nicholas12136/Senior-Design-Vivisense/mechanical/TowerConnector_to_tower.step

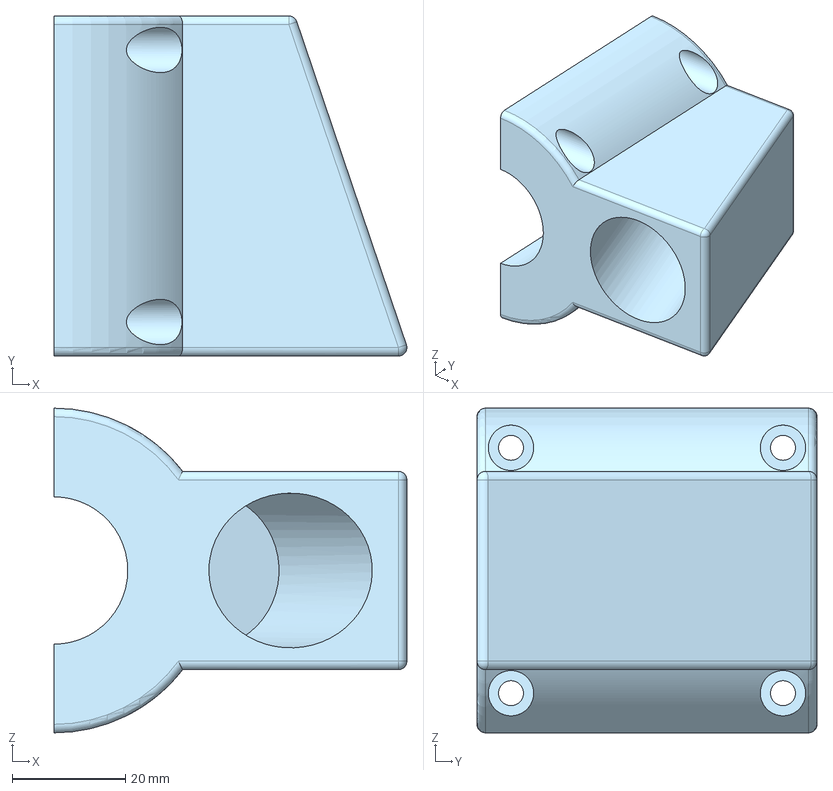
[picture p17: CAD file, 2026-05-02]
mechanical/TowerConnector_to_tower.step
62.3 x 60.0 x 57.3 mm
