nicholas12136/Senior-Design-Vivisense/mechanical/TowerLconnector_mirrored.stl

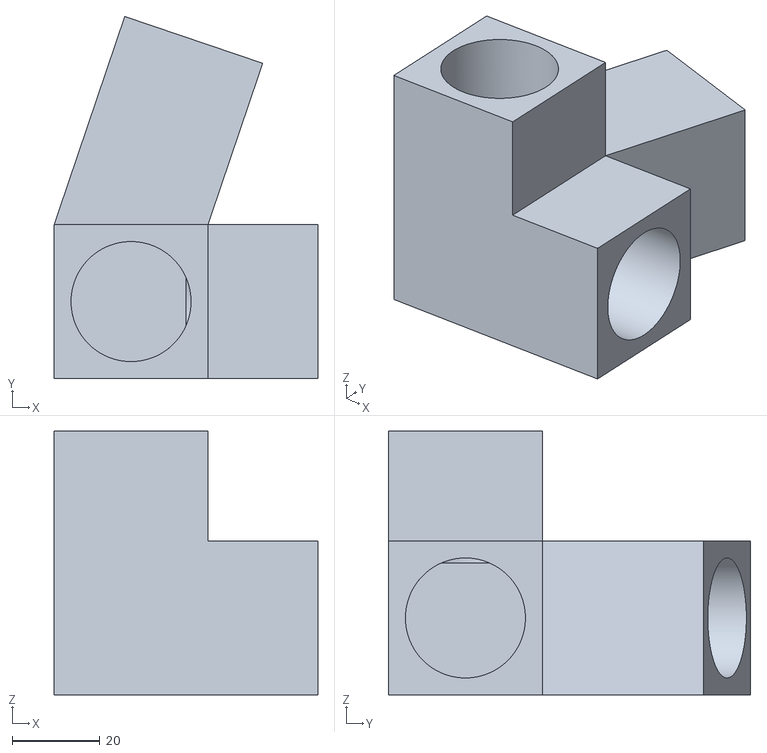
[picture p18: CAD file, 2026-05-02]
mechanical/TowerLconnector_mirrored.stl
60.0 x 82.3 x 60.0
