nicholas12136/Senior-Design-Vivisense/mechanical/LEDHolderV2.stl

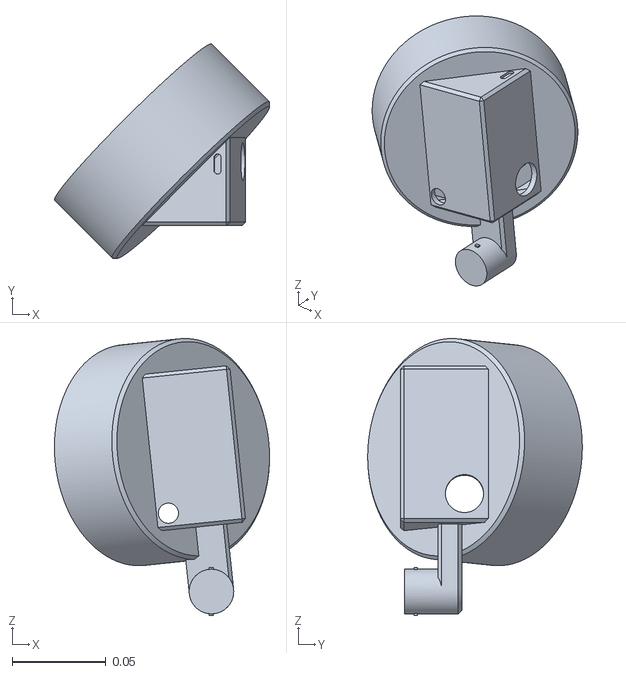
[picture p19: CAD file, 2026-04-17]
mechanical/LEDHolderV2.stl
0.115 x 0.114 x 0.148
