nicholas12136/Senior-Design-Vivisense/mechanical/Updated Clamp.stl

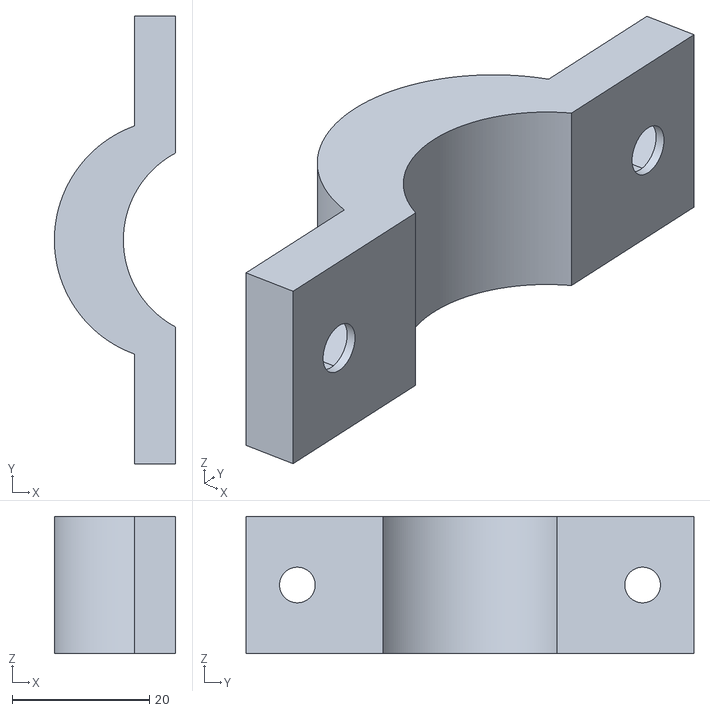
[picture p20: CAD file, 2026-04-14]
mechanical/Updated Clamp.stl
17.7 x 65.4 x 20.0
