nicholas12136/Senior-Design-Vivisense/mechanical/Outer Cover.step

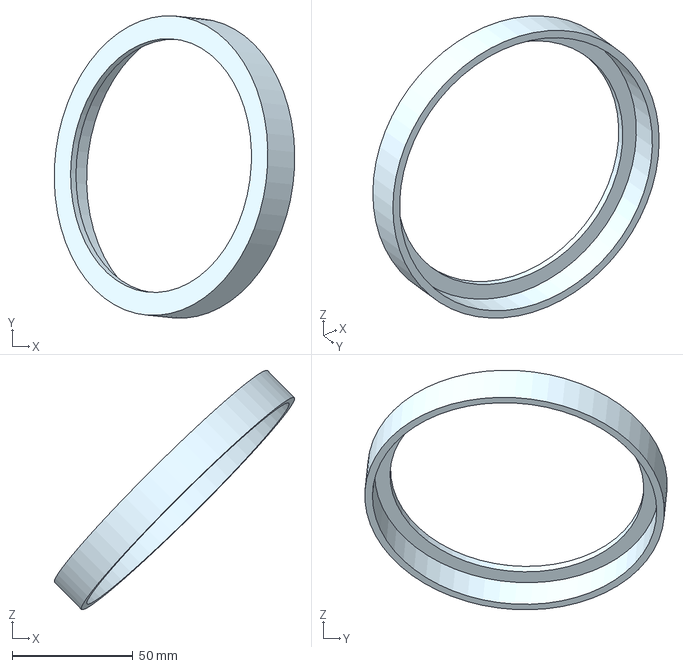
[picture p21: CAD file, 2026-04-14]
mechanical/Outer Cover.step
99.6 x 125.1 x 99.2 mm
