nicholas12136/Senior-Design-Vivisense/mechanical/LED Holder.step

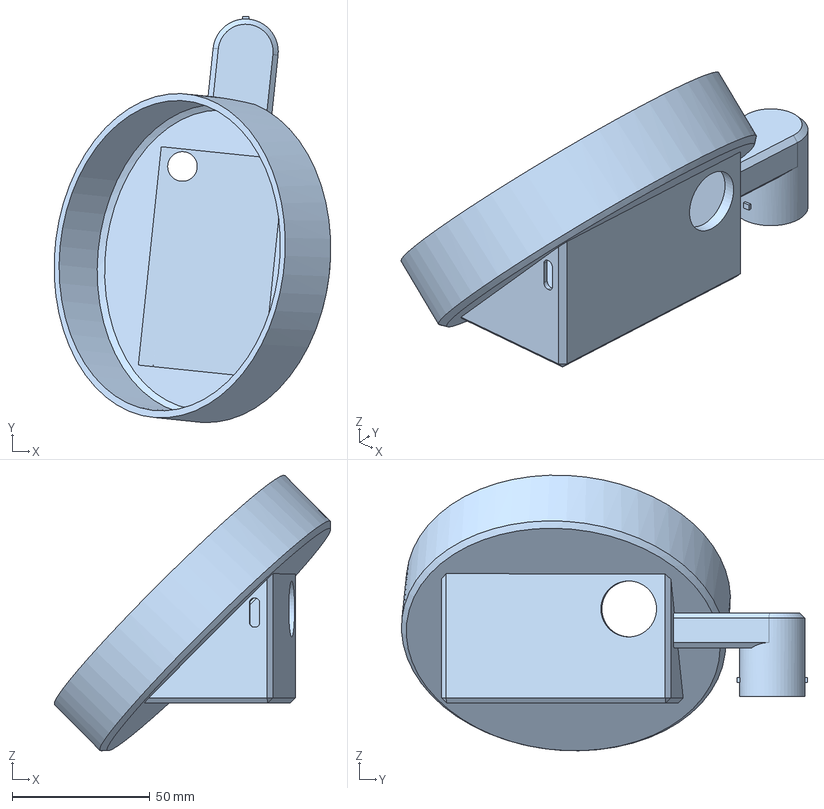
[picture p22: CAD file, 2026-04-14]
mechanical/LED Holder.step
100.4 x 147.5 x 100.1 mm
