nicholas12136/Senior-Design-Vivisense/mechanical/Diffraction Cover.step

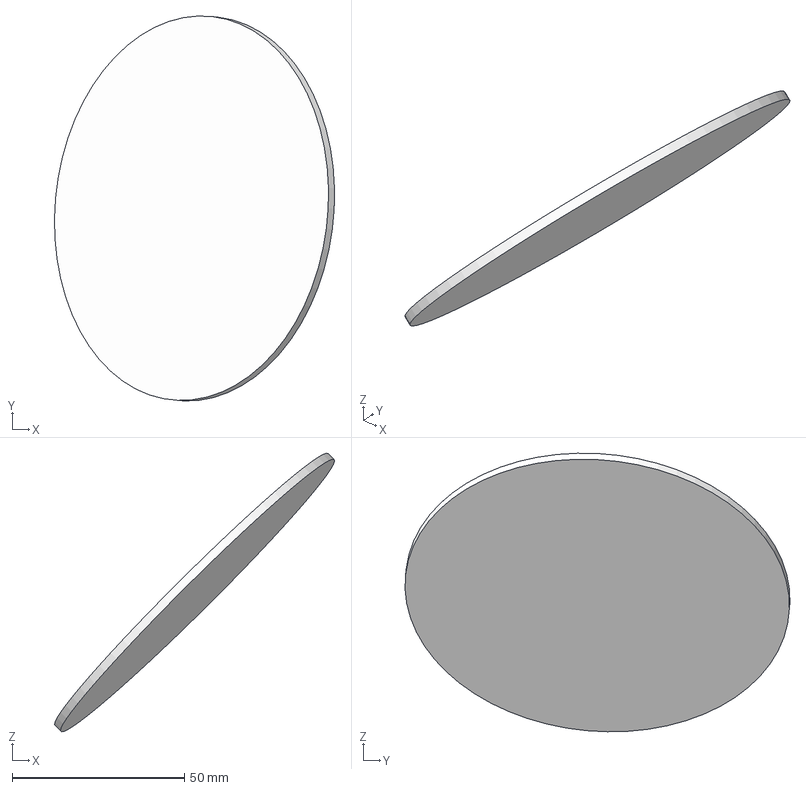
[picture p23: CAD file, 2026-04-14]
mechanical/Diffraction Cover.step
81.4 x 111.9 x 81.0 mm
