nicholas12136/Senior-Design-Vivisense/(list of files, cad)

Other CAD files:
mechanical/TowerLconnector.step
