nicholas12136/Senior-Design-Vivisense/simulation/matlab_visualizer/Unity Distance Output CSV/unityTest_8Sensors.csv

time_ms | s1_c01 | s1_c02 | s1_c03 | s1_c04 | s1_c05 | s1_c06 | s1_c07 | s1_c08 | s1_c09 | s1_c10 | s1_c11 | s1_c12 | s1_c13 | s1_c14 | s1_c15 | s1_c16 | s2_c01 | s2_c02 | s2_c03 | s2_c04 | s2_c05 | s2_c06 | s2_c07 | s2_c08 | s2_c09 | s2_c10 | s2_c11 | s2_c12 | s2_c13 | s2_c14 | s2_c15 | s2_c16 | s3_c01 | s3_c02 | s3_c03 | s3_c04 | s3_c05 | s3_c06 | s3_c07 | s3_c08 | s3_c09 | s3_c10 | s3_c11 | s3_c12 | s3_c13 | s3_c14 | s3_c15 | s3_c16 | s4_c01 | s4_c02 | s4_c03 | s4_c04 | s4_c05 | s4_c06 | s4_c07 | s4_c08 | s4_c09 | s4_c10 | s4_c11
0 | 500.0 | 500.0 | 500.0 | 500.0 | 1439.7 | 1439.7 | 1439.7 | 1439.7 | 3000.0 | 3000.0 | 3000.0 | 3000.0 | 3000.0 | 3000.0 | 3000.0 | 3000.0 | 500.0 | 500.0 | 500.0 | 500.0 | 1439.7 | 1439.7 | 1439.7 | 1439.7 | 1726.2 | 1837.0 | 2253.4 | 3000.0 | 1963.0 | 2089.0 | 2562.5 | 3000.0 | 500.0 | 500.0 | 500.0 | 500.0 | 1439.7 | 1439.7 | 1439.7 | 1439.7 | 3000.0 | 3000.0 | 3000.0 | 3000.0 | 3000.0 | 3000.0 | 3000.0 | 3000.0 | 500.0 | 500.0 | 500.0 | 500.0 | 1439.7 | 1439.7 | 1439.7 | 1439.7 | 3000.0 | 2253.4 | 1837.0
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
