nicholas12136/Senior-Design-Vivisense/Software/CaregiverApp/src/main.cpp

/*
 * ViviSense — Unified ESP32 Firmware
 *
 * Combines:
 *   - Caregiver app (WiFi/UI/audio + preview LED frames)
 *   - WiFi AP + WebSocket server
 *   - I2S audio playback   (webserver / webserver.ino)
 *
 * Hardware:
 *   - ESP32 DoIT DevKit V1
 *   - MAX98357A I2S amp: BCK=27, WS=26, DO=25
 *   - LED ring driven by a separate ESP32 via ESP-NOW
 *
 * Audio:
 *   - Copy audio_files/ from the webserver project into this directory
 *   - Run  python webserver/wav_to_header.py  to regenerate include/sounds.h
 *   - Flash filesystem:  pio run -t uploadfs
 *   - Flash firmware:    pio run -t upload
 *
 * WebSocket protocol (browser → ESP32):
 *   {"type":"obstacle",  "x":200,  "y":-760}
 *   {"type":"config",    "zoneMode":6, "brightness":80,
 *                        "redThreshold":60, "orangeThreshold":105, "yellowThreshold":150,
 *                        "activeSectors":[true,true,true,true,true,true]}   (cm)
 *   {"type":"navigate",  "action":"forward|backward|left|right|stop|speedup|slowdown|speak"}
 *   {"type":"volume",    "level":200}   (0–255)
 *   {"type":"preview",   "active":true, "zoneMode":6, "brightness":80,
 *                        "redThreshold":60, "orangeThreshold":105, "yellowThreshold":150,
 *                        "activeSectors":[true,true,true,true,true,true]}
 *   {"type":"preview",   "active":false}   → clears ring, resumes obstacle detection
 *
 * WebSocket protocol (ESP32 -> browser):
 *   {"type":"status", "zoneMode":6, "brightness":80, ...connectivity fields...}
 */

#include <Arduino.h>
#include <WiFi.h>
#include <esp_now.h>
#include <esp_wifi.h>
#include <SPIFFS.h>
#include <ESPAsyncWebServer.h>
#include <ArduinoJson.h>
#include "driver/i2s.h"
#include "sounds.h"
#include "led_frame.h"
#include <math.h>

// ── Hardware config ───────────────────────────────────────────────────────────
#define NUM_LEDS       93
#define ESPNOW_CHANNEL  1   // must match the LED ESP32's channel

static uint8_t LED_ESP32_MAC[] = {0x88, 0x56, 0xA6 , 0x6D , 0x0E , 0x8C};
static uint8_t MAIN_CONTROLLER_MAC[] = {0x5C, 0x01, 0x3B, 0x88, 0x04, 0x58};

// Broadcast MAC is still used for receiving heartbeat/status packets.
static const uint8_t BROADCAST_MAC[6] = {0xFF, 0xFF, 0xFF, 0xFF, 0xFF, 0xFF};

// ── Beta: inter-ESP32 packet types ────────────────────────────────────────────
const uint8_t MSG_CONFIG           = 0xB1;
const uint8_t MSG_COMPONENT_STATUS = 0xB4;

const uint8_t COMPONENT_MAIN_CONTROLLER = 1;
const uint8_t COMPONENT_LED_CONTROLLER  = 2;
const uint8_t LED_RENDER_MODE_SECTOR_FILL = 0;
const uint8_t LED_RENDER_MODE_RADAR = 1;
const bool ENABLE_NAV_AUDIO_PLAYBACK = false;

struct __attribute__((packed)) ConfigPacket {
  uint8_t  msg_type;           // MSG_CONFIG
  uint8_t  zone_mode;          // 4, 6, or 8
  uint8_t  brightness;         // 0-255 (capped at 50%)
  uint16_t red_threshold_mm;
  uint16_t orange_threshold_mm;
  uint16_t yellow_threshold_mm;
  uint8_t  audio_enabled;      // obstacle-audio feedback enable (not nav commands)
  uint8_t  visual_enabled;
  uint8_t  render_mode;
  uint8_t  active_sectors;     // bitmask — bit N = zone N enabled
  uint8_t  volume;             // 0–255 audio volume for MainController
  uint16_t red_pitch_hz;       // tonal chirp frequency for red zone (Hz)
  uint16_t red_tempo_ms;       // tonal chirp interval for red zone (ms)
  uint16_t orange_pitch_hz;
  uint16_t orange_tempo_ms;
  uint16_t yellow_pitch_hz;
  uint16_t yellow_tempo_ms;
  uint8_t  audio_mode;         // 0=tonal, 1=verbal
  uint8_t  obstacle_volume;    // 0-255 volume for obstacle audio only
};                             // 28 bytes

struct __attribute__((packed)) ComponentStatusPacket {
  uint8_t msg_type;
  uint8_t component_id;
  uint8_t sensor_seen_mask;
  uint8_t flags; // bit0=visualEnabled
};                        // 4 bytes

const uint8_t MSG_NAV_COMMAND  = 0xB6;

const uint8_t NAV_STOP     = 0;
const uint8_t NAV_FORWARD  = 1;
const uint8_t NAV_BACKWARD = 2;
const uint8_t NAV_LEFT     = 3;
const uint8_t NAV_RIGHT    = 4;
const uint8_t NAV_SPEEDUP  = 5;
const uint8_t NAV_SLOWDOWN = 6;
const uint8_t NAV_SPEAK    = 7;

struct __attribute__((packed)) NavigationCommandPacket {
  uint8_t msg_type;  // MSG_NAV_COMMAND
  uint8_t action;    // NAV_* constant
};                   // 2 bytes

#define I2S_BCK_IO  27
#define I2S_WS_IO   26
#define I2S_DO_IO   25
#define I2S_PORT    I2S_NUM_0

// ── Network config ────────────────────────────────────────────────────────────
const char* WIFI_SSID = "ViviSense";
const char* WIFI_PASS = "ViviSense123";

// ── Runtime state ─────────────────────────────────────────────────────────────
int currentBrightness = 26;   // UI default 20% (of capped 50% max)
int currentZoneMode   = 6;    // 4, 6, or 8
int currentVolume     = 255;  // 0–255

// ── Preview state (Display button on UI) ──────────────────────────────────────
bool  previewMode           = false;
int   previewZoneMode       = 6;
int   previewBrightness     = 26;
float previewRedMm          = 650.0f;
float previewOrangeMm       = 950.0f;
float previewYellowMm       = 1250.0f;
bool  previewActiveSectors[8]  = {true,true,true,true,true,true,false,false};
bool  currentActiveSectors[8] = {true,true,true,true,true,true,true,true};
uint8_t latestSensorSeenMask = 0;
uint8_t currentRenderMode = LED_RENDER_MODE_SECTOR_FILL;
uint32_t lastMainControllerStatusMs = 0;
uint32_t lastLedControllerStatusMs = 0;
uint32_t lastWsStatusBroadcastMs = 0;
const uint32_t COMPONENT_TIMEOUT_MS = 1500;
const uint32_t WS_STATUS_PERIOD_MS = 500;
static constexpr int BRIGHTNESS_MAX_RAW = 128;     // 50%
static int brightnessRawFromPercent(float percent)
{
  float clampedPercent = constrain(percent, 0.0f, 100.0f);
  int raw = (int)lroundf((clampedPercent / 100.0f) * (float)BRIGHTNESS_MAX_RAW);
  return constrain(raw, 0, BRIGHTNESS_MAX_RAW);
}
static int brightnessPercentFromRaw(int raw)
{
  int clampedRaw = constrain(raw, 0, BRIGHTNESS_MAX_RAW);
  return (int)lroundf((float)clampedRaw * (100.0f / (float)BRIGHTNESS_MAX_RAW));
}

bool audioEnabled  = false;  // play audio during obstacle detection
bool visualEnabled = false;  // light LEDs during obstacle detection
uint8_t audioMode       = 0;    // 0=tonal, 1=verbal
uint8_t obstacleVolume  = 200;  // 0-255 volume for obstacle audio

// Tonal chirp defaults — pitch (Hz) and interval (ms) per zone.
uint16_t toneRedPitchHz    = 1200;
uint16_t toneRedTempoMs    =  150;
uint16_t toneOrangePitchHz =  800;
uint16_t toneOrangeTempoMs =  500;
uint16_t toneYellowPitchHz =  400;
uint16_t toneYellowTempoMs = 1000;

// Distance thresholds in mm.
// Defaults match the UI's default cm values × 10.
float DIST_RING1 = 325.0f;   // inner red boundary   (= kDefaultRedThresholdMm * 0.5)
float DIST_RING2 = 650.0f;   // red / orange boundary (= kDefaultRedThresholdMm)
float DIST_RING3 = 950.0f;   // orange boundary       (= kDefaultOrangeThresholdMm)
float DIST_RING4 = 1250.0f;  // yellow boundary       (= kDefaultYellowThresholdMm)
float DIST_RING5 = 1400.0f;  // yellow-green ring     (= kDefaultYellowThresholdMm + (yellow-orange)*0.5)

// ── Server & WebSocket ────────────────────────────────────────────────────────
AsyncWebServer httpServer(80);
AsyncWebSocket wsServer("/ws");

// =========================================================
// RING 1 (1 LED, center — no zones)
// =========================================================
int ring1_any[] = {92, -1};

// =========================================================
// 6-ZONE ARRAYS  (AHEAD / TOP_RIGHT / BOTTOM_RIGHT /
//                 BEHIND / BOTTOM_LEFT / TOP_LEFT)
// =========================================================
int r2_6_AHEAD[]        = {84, -1};
int r2_6_TOP_RIGHT[]    = {85, 86, -1};
int r2_6_BOTTOM_RIGHT[] = {87, -1};
int r2_6_BEHIND[]       = {88, -1};
int r2_6_BOTTOM_LEFT[]  = {89, 90, -1};
int r2_6_TOP_LEFT[]     = {91, -1};

int r3_6_AHEAD[]        = {72, -1};
int r3_6_TOP_RIGHT[]    = {73, 74, 75, -1};
int r3_6_BOTTOM_RIGHT[] = {76, 77, -1};
int r3_6_BEHIND[]       = {78, -1};
int r3_6_BOTTOM_LEFT[]  = {79, 80, -1};
int r3_6_TOP_LEFT[]     = {81, 82, 83, -1};

int r4_6_AHEAD[]        = {56, 57, 71, -1};
int r4_6_TOP_RIGHT[]    = {58, 59, 60, -1};
int r4_6_BOTTOM_RIGHT[] = {61, 62, -1};
int r4_6_BEHIND[]       = {63, 64, 65, -1};
int r4_6_BOTTOM_LEFT[]  = {66, 67, -1};
int r4_6_TOP_LEFT[]     = {68, 69, 70, -1};

int r5_6_AHEAD[]        = {32, 33, 55, -1};
int r5_6_TOP_RIGHT[]    = {34, 35, 36, 37, 38, -1};
int r5_6_BOTTOM_RIGHT[] = {39, 40, 41, -1};
int r5_6_BEHIND[]       = {42, 43, 44, -1};
int r5_6_BOTTOM_LEFT[]  = {45, 46, 47, 48, -1};
int r5_6_TOP_LEFT[]     = {49, 50, 51, 52, 53, 54, -1};

int r6_6_AHEAD[]        = {29, 30, 31, 0, 1, -1};
int r6_6_TOP_RIGHT[]    = {2, 3, 4, 5, 6, 7, 8, -1};
int r6_6_BOTTOM_RIGHT[] = {9, 10, 11, 12, -1};
int r6_6_BEHIND[]       = {13, 14, 15, 16, -1};
int r6_6_BOTTOM_LEFT[]  = {17, 18, 19, 20, 21, 22, -1};
int r6_6_TOP_LEFT[]     = {23, 24, 25, 26, 27, 28, -1};

// =========================================================
// 4-ZONE ARRAYS  (N / E / S / W)
// =========================================================
int r2_4_N[] = {91, 84, -1};
int r2_4_E[] = {85, 86, -1};
int r2_4_S[] = {87, 88, -1};
int r2_4_W[] = {89, 90, -1};

int r3_4_N[] = {82, 83, 72, -1};
int r3_4_E[] = {73, 75, 76, -1};
int r3_4_S[] = {74, 77, 78, -1};
int r3_4_W[] = {79, 80, 81, -1};

int r4_4_N[] = {70, 71, 56, 57, -1};
int r4_4_E[] = {58, 59, 60, 61, -1};
int r4_4_S[] = {62, 63, 64, 65, -1};
int r4_4_W[] = {66, 67, 68, 69, -1};

int r5_4_N[] = {53, 54, 55, 32, 33, 34, -1};
int r5_4_E[] = {35, 36, 37, 38, 39, 40, -1};
int r5_4_S[] = {41, 42, 43, 44, 45, 46, -1};
int r5_4_W[] = {47, 48, 49, 50, 51, 52, -1};

int r6_4_N[] = {28, 29, 30, 31, 0, 1, 2, 3, -1};
int r6_4_E[] = {4, 5, 6, 7, 8, 9, 10, 11, -1};
int r6_4_S[] = {12, 13, 14, 15, 16, 17, 18, 19, -1};
int r6_4_W[] = {20, 21, 22, 23, 24, 25, 26, 27, -1};

// =========================================================
// 8-ZONE ARRAYS  (N / NE / E / SE / S / SW / W / NW)
// =========================================================
int r2_8_N[]  = {91, -1};  int r2_8_NE[] = {84, -1};
int r2_8_E[]  = {85, -1};  int r2_8_SE[] = {86, -1};
int r2_8_S[]  = {87, -1};  int r2_8_SW[] = {88, -1};
int r2_8_W[]  = {89, -1};  int r2_8_NW[] = {90, -1};

int r3_8_N[]  = {83, 72, -1};  int r3_8_NE[] = {73, -1};
int r3_8_E[]  = {74, 75, -1};  int r3_8_SE[] = {76, -1};
int r3_8_S[]  = {77, 78, -1};  int r3_8_SW[] = {79, -1};
int r3_8_W[]  = {80, 81, -1};  int r3_8_NW[] = {82, -1};

int r4_8_N[]  = {71, 56, -1};  int r4_8_NE[] = {57, 58, -1};
int r4_8_E[]  = {59, 60, -1};  int r4_8_SE[] = {61, 62, -1};
int r4_8_S[]  = {63, 64, -1};  int r4_8_SW[] = {65, 66, -1};
int r4_8_W[]  = {67, 68, -1};  int r4_8_NW[] = {69, 70, -1};

int r5_8_N[]  = {54, 55, 32, -1};  int r5_8_NE[] = {33, 34, 35, -1};
int r5_8_E[]  = {36, 37, 38, -1};  int r5_8_SE[] = {39, 40, 41, -1};
int r5_8_S[]  = {42, 43, 44, -1};  int r5_8_SW[] = {45, 46, 47, -1};
int r5_8_W[]  = {48, 49, 50, -1};  int r5_8_NW[] = {51, 52, 53, -1};

int r6_8_N[]  = {30, 31, 0, 1, -1};    int r6_8_NE[] = {2, 3, 4, 5, -1};
int r6_8_E[]  = {6, 7, 8, 9, -1};      int r6_8_SE[] = {10, 11, 12, 13, -1};
int r6_8_S[]  = {14, 15, 16, 17, -1};  int r6_8_SW[] = {18, 19, 20, 21, -1};
int r6_8_W[]  = {22, 23, 24, 25, -1};  int r6_8_NW[] = {26, 27, 28, 29, -1};

// =========================================================
// ESP-NOW HELPERS
// =========================================================

// ── Beta: forward declarations (functions defined later in this file) ─────────
static uint8_t ringToColorCode(int ring);
static void fillZoneInFrame(LedFrame_t &frame, int *ledArray, uint8_t colorCode);
static void sendLedFrame(const LedFrame_t &frame);
int *getZone4(int ring, float angleDeg);
int *getZone6(int ring, float angleDeg);
int *getZone8(int ring, float angleDeg);

// ESP-NOW receive callback.
void onEspNowReceived(const uint8_t *mac, const uint8_t *data, int len)
{
  (void)mac;

  if (len == (int)sizeof(ComponentStatusPacket))
  {
    const ComponentStatusPacket *pkt =
        reinterpret_cast<const ComponentStatusPacket *>(data);
    if (pkt->msg_type == MSG_COMPONENT_STATUS)
    {
      if (pkt->component_id == COMPONENT_MAIN_CONTROLLER)
      {
        latestSensorSeenMask = pkt->sensor_seen_mask;
        lastMainControllerStatusMs = millis();
      }
      else if (pkt->component_id == COMPONENT_LED_CONTROLLER)
      {
        lastLedControllerStatusMs = millis();
      }
    }
    return;
  }

}

// Sends current settings to MainController.
// When overrideVisualEnabled >= 0, that value is sent instead of visualEnabled.
void sendConfigToMainController(int overrideVisualEnabled = -1)
{
  ConfigPacket cfg;
  cfg.msg_type            = MSG_CONFIG;
  cfg.zone_mode           = (uint8_t)currentZoneMode;
  cfg.brightness          = (uint8_t)currentBrightness;
  cfg.red_threshold_mm    = (uint16_t)DIST_RING2;
  cfg.orange_threshold_mm = (uint16_t)DIST_RING3;
  cfg.yellow_threshold_mm = (uint16_t)DIST_RING4;
  cfg.audio_enabled       = audioEnabled ? 1 : 0;
  cfg.visual_enabled      = (overrideVisualEnabled >= 0)
                              ? (uint8_t)(overrideVisualEnabled ? 1 : 0)
                              : (uint8_t)(visualEnabled ? 1 : 0);
  cfg.render_mode         = (uint8_t)currentRenderMode;
  cfg.active_sectors      = 0;
  for (int i = 0; i < currentZoneMode; i++)
    if (currentActiveSectors[i]) cfg.active_sectors |= (uint8_t)(1 << i);
  cfg.volume              = (uint8_t)currentVolume;
  cfg.red_pitch_hz        = toneRedPitchHz;
  cfg.red_tempo_ms        = toneRedTempoMs;
  cfg.orange_pitch_hz     = toneOrangePitchHz;
  cfg.orange_tempo_ms     = toneOrangeTempoMs;
  cfg.yellow_pitch_hz     = toneYellowPitchHz;
  cfg.yellow_tempo_ms     = toneYellowTempoMs;
  cfg.audio_mode          = audioMode;
  cfg.obstacle_volume     = obstacleVolume;
  esp_err_t err = esp_now_send(MAIN_CONTROLLER_MAC, (const uint8_t *)&cfg, sizeof(cfg));
  if (err != ESP_OK) Serial.printf("[ESP-NOW] Config send error: 0x%x\n", err);
}

static uint8_t ringToColorCode(int ring) {
  if (ring <= 2) return LED_COLOR_RED;
  if (ring <= 4) return LED_COLOR_ORANGE;
  return LED_COLOR_YELLOW;
}

static void fillZoneInFrame(LedFrame_t& frame, int* ledArray, uint8_t colorCode) {
  for (int i = 0; ledArray[i] != -1; i++) {
    int led = ledArray[i];
    if (led >= 0 && led < NUM_LEDS) frame.leds[led] = colorCode;
  }
}

static void sendLedFrame(const LedFrame_t& frame) {
  esp_err_t err = esp_now_send(LED_ESP32_MAC, (const uint8_t*)&frame, sizeof(LedFrame_t));
  if (err != ESP_OK) Serial.printf("[ESP-NOW] Send error: 0x%x\n", err);
}

static void sendClearFrame() {
  LedFrame_t frame = {};
  frame.brightness = (uint8_t)currentBrightness;
  sendLedFrame(frame);
}

static void onEspNowSent(const uint8_t* mac, esp_now_send_status_t status) {
  const char* target = "OTHER";
  if (mac != nullptr) {
    if (memcmp(mac, LED_ESP32_MAC, 6) == 0) target = "LED";
    else if (memcmp(mac, MAIN_CONTROLLER_MAC, 6) == 0) target = "MAIN";
    else if (memcmp(mac, BROADCAST_MAC, 6) == 0) target = "BROADCAST";
    Serial.printf("[ESP-NOW] %s send %s (%02X:%02X:%02X:%02X:%02X:%02X)\n",
                  target,
                  status == ESP_NOW_SEND_SUCCESS ? "OK" : "FAILED",
                  mac[0], mac[1], mac[2], mac[3], mac[4], mac[5]);
  } else {
    Serial.printf("[ESP-NOW] %s send %s\n",
                  target,
                  status == ESP_NOW_SEND_SUCCESS ? "OK" : "FAILED");
  }
}

void initEspNow() {
  if (esp_now_init() != ESP_OK) {
    Serial.println("[ESP-NOW] Init FAILED");
    return;
  }
  esp_now_register_send_cb(onEspNowSent);
  esp_now_register_recv_cb(onEspNowReceived);

  // Live proximity rendering runs from MainController -> LEDRingController.
  // This unit transmits config to MainController and preview frames to LED.

  // LED controller peer (unicast — LED frames for normal operation + preview)
  {
    esp_now_peer_info_t peerInfo = {};
    memcpy(peerInfo.peer_addr, LED_ESP32_MAC, 6);
    peerInfo.channel = ESPNOW_CHANNEL;
    peerInfo.ifidx   = WIFI_IF_AP;
    peerInfo.encrypt = false;
    if (esp_now_add_peer(&peerInfo) != ESP_OK)
      Serial.println("[ESP-NOW] LED peer FAILED");
    else
      Serial.println("[ESP-NOW] LED peer registered");
  }

  // MainController peer (unicast) - config + mode control.
  {
    esp_now_peer_info_t mainPeer = {};
    memcpy(mainPeer.peer_addr, MAIN_CONTROLLER_MAC, 6);
    mainPeer.channel = ESPNOW_CHANNEL;
    mainPeer.ifidx   = WIFI_IF_AP;
    mainPeer.encrypt = false;
    if (esp_now_add_peer(&mainPeer) != ESP_OK)
      Serial.println("[ESP-NOW] MainController peer FAILED");
    else
      Serial.println("[ESP-NOW] MainController peer registered");
  }

  // Broadcast peer for compatibility with received status traffic.
  {
    esp_now_peer_info_t broadcastPeer = {};
    memcpy(broadcastPeer.peer_addr, BROADCAST_MAC, 6);
    broadcastPeer.channel = ESPNOW_CHANNEL;
    broadcastPeer.ifidx   = WIFI_IF_AP;
    broadcastPeer.encrypt = false;
    if (esp_now_add_peer(&broadcastPeer) != ESP_OK)
      Serial.println("[ESP-NOW] Broadcast peer FAILED");
    else
      Serial.println("[ESP-NOW] Broadcast peer registered");
  }
}

// Recalculate all ring boundaries from the three color thresholds.
void applyThresholds(float redMaxMm, float orangeMaxMm, float yellowMaxMm) {
  if (redMaxMm <= 0.0f) return;
  if (orangeMaxMm <= redMaxMm) return;
  if (yellowMaxMm <= orangeMaxMm) return;
  DIST_RING1 = redMaxMm * 0.5f;
  DIST_RING2 = redMaxMm;
  DIST_RING3 = orangeMaxMm;
  DIST_RING4 = yellowMaxMm;
  DIST_RING5 = yellowMaxMm + (yellowMaxMm - orangeMaxMm) * 0.5f;
}

// =========================================================
// PREVIEW HELPERS
// =========================================================

// Forward declarations — zone pickers are defined after this section.
int* getZone4(int ring, float angleDeg);
int* getZone6(int ring, float angleDeg);
int* getZone8(int ring, float angleDeg);

// Representative distance (mm) for each ring (index = ring number 1-6).
// Mirrors the UI's RING_DISTANCES = [20,50,100,150,200,300] cm.
static const float PREVIEW_RING_DIST_MM[] = {0, 200, 500, 1000, 1500, 2000, 3000};

// One representative angle per zone index for each zone mode.
// Matches the label order in the TypeScript: N/E/S/W,  AHEAD/TR/BR/BEHIND/BL/TL,  N/NE/E/SE/S/SW/W/NW
static const float ZONE4_ANGLES[] = {0, 90, 180, -90};
static const float ZONE6_ANGLES[] = {0, 60, 120, 180, -120, -60};
static const float ZONE8_ANGLES[] = {0, 45, 90, 135, 180, -135, -90, -45};

// Light the full ring as it appears in the Live Preview on the UI:
// all rings shown simultaneously, only active sectors lit, colour based on thresholds.
void lightPreview() {
  LedFrame_t frame = {};
  frame.brightness = (uint8_t)previewBrightness;

  int zoneCount = previewZoneMode;
  const float* zoneAngles = (zoneCount == 4) ? ZONE4_ANGLES :
                            (zoneCount == 8) ? ZONE8_ANGLES : ZONE6_ANGLES;

  for (int ring = 1; ring <= 6; ring++) {
    float dist = PREVIEW_RING_DIST_MM[ring];

    uint8_t colorCode;
    if      (dist <= previewRedMm)    colorCode = LED_COLOR_RED;
    else if (dist <= previewOrangeMm) colorCode = LED_COLOR_ORANGE;
    else if (dist <= previewYellowMm) colorCode = LED_COLOR_YELLOW;
    else                              colorCode = LED_COLOR_GREEN;

    for (int z = 0; z < zoneCount; z++) {
      if (!previewActiveSectors[z]) continue;
      int* leds;
      if (ring == 1) {
        leds = ring1_any;
      } else if (zoneCount == 4) {
        leds = getZone4(ring, zoneAngles[z]);
      } else if (zoneCount == 8) {
        leds = getZone8(ring, zoneAngles[z]);
      } else {
        leds = getZone6(ring, zoneAngles[z]);
      }
      fillZoneInFrame(frame, leds, colorCode);
    }
  }
  frame.leds[92] = LED_COLOR_BLUE;
  sendLedFrame(frame);
}

// =========================================================
// ZONE PICKERS
// =========================================================

int* getZone4(int ring, float angleDeg) {
  int zone;
  if      (angleDeg >= -45 && angleDeg <  45)  zone = 1; // N
  else if (angleDeg >=  45 && angleDeg < 135)  zone = 2; // E
  else if (angleDeg < -135 || angleDeg >= 135) zone = 3; // S
  else                                          zone = 4; // W

  switch (ring) {
    case 2: return (zone==1)?r2_4_N:(zone==2)?r2_4_E:(zone==3)?r2_4_S:r2_4_W;
    case 3: return (zone==1)?r3_4_N:(zone==2)?r3_4_E:(zone==3)?r3_4_S:r3_4_W;
    case 4: return (zone==1)?r4_4_N:(zone==2)?r4_4_E:(zone==3)?r4_4_S:r4_4_W;
    case 5: return (zone==1)?r5_4_N:(zone==2)?r5_4_E:(zone==3)?r5_4_S:r5_4_W;
    case 6: return (zone==1)?r6_4_N:(zone==2)?r6_4_E:(zone==3)?r6_4_S:r6_4_W;
  }
  return ring1_any;
}

int* getZone6(int ring, float angleDeg) {
  int zone;
  if      (angleDeg >= -30  && angleDeg <  30)  zone = 1; // AHEAD
  else if (angleDeg >=  30  && angleDeg <=  90)  zone = 2; // TOP_RIGHT
  else if (angleDeg >   90  && angleDeg < 150)  zone = 3; // BOTTOM_RIGHT
  else if (angleDeg <  -150 || angleDeg >= 150) zone = 4; // BEHIND
  else if (angleDeg >= -150 && angleDeg < -90)  zone = 5; // BOTTOM_LEFT
  else                                           zone = 6; // TOP_LEFT

  switch (ring) {
    case 2:
      if (zone==1) return r2_6_AHEAD; if (zone==2) return r2_6_TOP_RIGHT;
      if (zone==3) return r2_6_BOTTOM_RIGHT; if (zone==4) return r2_6_BEHIND;
      if (zone==5) return r2_6_BOTTOM_LEFT; return r2_6_TOP_LEFT;
    case 3:
      if (zone==1) return r3_6_AHEAD; if (zone==2) return r3_6_TOP_RIGHT;
      if (zone==3) return r3_6_BOTTOM_RIGHT; if (zone==4) return r3_6_BEHIND;
      if (zone==5) return r3_6_BOTTOM_LEFT; return r3_6_TOP_LEFT;
    case 4:
      if (zone==1) return r4_6_AHEAD; if (zone==2) return r4_6_TOP_RIGHT;
      if (zone==3) return r4_6_BOTTOM_RIGHT; if (zone==4) return r4_6_BEHIND;
      if (zone==5) return r4_6_BOTTOM_LEFT; return r4_6_TOP_LEFT;
    case 5:
      if (zone==1) return r5_6_AHEAD; if (zone==2) return r5_6_TOP_RIGHT;
      if (zone==3) return r5_6_BOTTOM_RIGHT; if (zone==4) return r5_6_BEHIND;
      if (zone==5) return r5_6_BOTTOM_LEFT; return r5_6_TOP_LEFT;
    case 6:
      if (zone==1) return r6_6_AHEAD; if (zone==2) return r6_6_TOP_RIGHT;
      if (zone==3) return r6_6_BOTTOM_RIGHT; if (zone==4) return r6_6_BEHIND;
      if (zone==5) return r6_6_BOTTOM_LEFT; return r6_6_TOP_LEFT;
  }
  return ring1_any;
}

int* getZone8(int ring, float angleDeg) {
  int zone;
  if      (angleDeg >= -22.5 && angleDeg <  22.5)  zone = 1; // N
  else if (angleDeg >=  22.5 && angleDeg <  67.5)  zone = 2; // NE
  else if (angleDeg >=  67.5 && angleDeg < 112.5)  zone = 3; // E
  else if (angleDeg >= 112.5 && angleDeg < 157.5)  zone = 4; // SE
  else if (angleDeg < -157.5 || angleDeg >= 157.5) zone = 5; // S
  else if (angleDeg >= -157.5 && angleDeg < -112.5) zone = 6; // SW
  else if (angleDeg >= -112.5 && angleDeg <  -67.5) zone = 7; // W
  else                                               zone = 8; // NW

  switch (ring) {
    case 2:
      if (zone==1) return r2_8_N; if (zone==2) return r2_8_NE;
      if (zone==3) return r2_8_E; if (zone==4) return r2_8_SE;
      if (zone==5) return r2_8_S; if (zone==6) return r2_8_SW;
      if (zone==7) return r2_8_W; return r2_8_NW;
    case 3:
      if (zone==1) return r3_8_N; if (zone==2) return r3_8_NE;
      if (zone==3) return r3_8_E; if (zone==4) return r3_8_SE;
      if (zone==5) return r3_8_S; if (zone==6) return r3_8_SW;
      if (zone==7) return r3_8_W; return r3_8_NW;
    case 4:
      if (zone==1) return r4_8_N; if (zone==2) return r4_8_NE;
      if (zone==3) return r4_8_E; if (zone==4) return r4_8_SE;
      if (zone==5) return r4_8_S; if (zone==6) return r4_8_SW;
      if (zone==7) return r4_8_W; return r4_8_NW;
    case 5:
      if (zone==1) return r5_8_N; if (zone==2) return r5_8_NE;
      if (zone==3) return r5_8_E; if (zone==4) return r5_8_SE;
      if (zone==5) return r5_8_S; if (zone==6) return r5_8_SW;
      if (zone==7) return r5_8_W; return r5_8_NW;
    case 6:
      if (zone==1) return r6_8_N; if (zone==2) return r6_8_NE;
      if (zone==3) return r6_8_E; if (zone==4) return r6_8_SE;
      if (zone==5) return r6_8_S; if (zone==6) return r6_8_SW;
      if (zone==7) return r6_8_W; return r6_8_NW;
  }
  return ring1_any;
}

// =========================================================
// OBSTACLE PROCESSING
// =========================================================

// Returns the 0-based zone index for an angle + zone mode.
// Index order matches the activeSectors[] arrays sent by the UI:
//   4-zone: N=0, E=1, S=2, W=3
//   6-zone: AHEAD=0, TOP_RIGHT=1, BOTTOM_RIGHT=2, BEHIND=3, BOTTOM_LEFT=4, TOP_LEFT=5
//   8-zone: N=0, NE=1, E=2, SE=3, S=4, SW=5, W=6, NW=7
int getZoneIndex(float angleDeg, int zoneMode) {
  if (zoneMode == 4) {
    if (angleDeg >= -45  && angleDeg <   45) return 0; // N
    if (angleDeg >=  45  && angleDeg <  135) return 1; // E
    if (angleDeg < -135  || angleDeg >= 135) return 2; // S
    return 3; // W
  }
  if (zoneMode == 8) {
    if (angleDeg >= -22.5 && angleDeg <  22.5) return 0; // N
    if (angleDeg >=  22.5 && angleDeg <  67.5) return 1; // NE
    if (angleDeg >=  67.5 && angleDeg < 112.5) return 2; // E
    if (angleDeg >= 112.5 && angleDeg < 157.5) return 3; // SE
    if (angleDeg < -157.5 || angleDeg >= 157.5) return 4; // S
    if (angleDeg >= -157.5 && angleDeg < -112.5) return 5; // SW
    if (angleDeg >= -112.5 && angleDeg <  -67.5) return 6; // W
    return 7; // NW
  }
  // 6 zones
  if (angleDeg >= -30  && angleDeg <  30)  return 0; // AHEAD
  if (angleDeg >=  30  && angleDeg <=  90) return 1; // TOP_RIGHT
  if (angleDeg >   90  && angleDeg < 150) return 2; // BOTTOM_RIGHT
  if (angleDeg < -150  || angleDeg >= 150) return 3; // BEHIND
  if (angleDeg >= -150 && angleDeg < -90)  return 4; // BOTTOM_LEFT
  return 5; // TOP_LEFT
}

void processCoordinates(float x, float y) {
  if (previewMode) return;
  if (!visualEnabled) return;
  float distance = sqrt(x * x + y * y);

  if (distance > 3000.0f) {
    sendClearFrame();
    return;
  }

  int ring;
  if      (distance < DIST_RING1) ring = 1;
  else if (distance < DIST_RING2) ring = 2;
  else if (distance < DIST_RING3) ring = 3;
  else if (distance < DIST_RING4) ring = 4;
  else if (distance < DIST_RING5) ring = 5;
  else                            ring = 6;

  float angleRad = atan2(-y, x);
  float angleDeg = angleRad * (180.0f / PI);

  // Ring 1 (center LED) is omnidirectional — always shown.
  if (ring != 1 && !currentActiveSectors[getZoneIndex(angleDeg, currentZoneMode)]) {
    sendClearFrame();
    return;
  }

  int* zone;
  if (ring == 1) {
    zone = ring1_any;
  } else if (currentZoneMode == 4) {
    zone = getZone4(ring, angleDeg);
  } else if (currentZoneMode == 8) {
    zone = getZone8(ring, angleDeg);
  } else {
    zone = getZone6(ring, angleDeg);
  }

  LedFrame_t frame = {};
  frame.brightness = (uint8_t)currentBrightness;
  fillZoneInFrame(frame, zone, ringToColorCode(ring));
  sendLedFrame(frame);
}

// =========================================================
// AUDIO ENGINE (I2S + MAX98357A)
// =========================================================

void setupI2S() {
  i2s_config_t cfg = {
    .mode                 = (i2s_mode_t)(I2S_MODE_MASTER | I2S_MODE_TX),
    .sample_rate          = 16000,
    .bits_per_sample      = I2S_BITS_PER_SAMPLE_16BIT,
    .channel_format       = I2S_CHANNEL_FMT_RIGHT_LEFT,
    .communication_format = I2S_COMM_FORMAT_STAND_I2S,
    .intr_alloc_flags     = ESP_INTR_FLAG_LEVEL1,
    .dma_buf_count        = 8,
    .dma_buf_len          = 128,
    .use_apll             = false,
  };
  i2s_driver_install(I2S_PORT, &cfg, 0, NULL);

  i2s_pin_config_t pins = {
    .bck_io_num   = I2S_BCK_IO,
    .ws_io_num    = I2S_WS_IO,
    .data_out_num = I2S_DO_IO,
    .data_in_num  = I2S_PIN_NO_CHANGE,
  };
  i2s_set_pin(I2S_PORT, &pins);
}

void playAudio(const unsigned char* audioData, unsigned int dataLen, unsigned int sampleRate) {
  if (!ENABLE_NAV_AUDIO_PLAYBACK) {
    (void)audioData;
    (void)dataLen;
    (void)sampleRate;
    Serial.println("[Audio] Navigation playback disabled in beta firmware");
    return;
  }
  if (dataLen == 0) return;
  i2s_set_sample_rates(I2S_PORT, sampleRate);

  size_t  bytesWritten;
  int16_t buf[128];
  int     bufIdx   = 0;
  float   volFactor = (float)currentVolume / 255.0f;

  for (unsigned int i = 0; i + 1 < dataLen; i += 2) {
    uint8_t lo  = pgm_read_byte(&audioData[i]);
    uint8_t hi  = pgm_read_byte(&audioData[i + 1]);
    int16_t smp = (int16_t)((hi << 8) | lo);
    smp = (int16_t)(smp * volFactor);
    buf[bufIdx++] = smp; // Left
    buf[bufIdx++] = smp; // Right
    if (bufIdx >= 128) {
      i2s_write(I2S_PORT, buf, sizeof(buf), &bytesWritten, portMAX_DELAY);
      bufIdx = 0;
    }
  }
  if (bufIdx > 0)
    i2s_write(I2S_PORT, buf, bufIdx * 2, &bytesWritten, portMAX_DELAY);
  i2s_zero_dma_buffer(I2S_PORT);
}

// =========================================================
// NAVIGATION COMMANDS — forwarded to MainController over ESP-NOW
// (MainController owns the speaker; it plays the audio clip)
// =========================================================

static const char* navActionName(uint8_t action) {
  switch (action) {
    case NAV_STOP:     return "STOP";
    case NAV_FORWARD:  return "FORWARD";
    case NAV_BACKWARD: return "BACKWARD";
    case NAV_LEFT:     return "LEFT";
    case NAV_RIGHT:    return "RIGHT";
    case NAV_SPEEDUP:  return "SPEEDUP";
    case NAV_SLOWDOWN: return "SLOWDOWN";
    case NAV_SPEAK:    return "SPEAK";
    default:           return "UNKNOWN";
  }
}

void sendNavigationCommand(uint8_t action) {
  NavigationCommandPacket pkt;
  pkt.msg_type = MSG_NAV_COMMAND;
  pkt.action   = action;
  Serial.printf("[Nav TX] %s -> %02X:%02X:%02X:%02X:%02X:%02X\n",
                navActionName(action),
                MAIN_CONTROLLER_MAC[0], MAIN_CONTROLLER_MAC[1], MAIN_CONTROLLER_MAC[2],
                MAIN_CONTROLLER_MAC[3], MAIN_CONTROLLER_MAC[4], MAIN_CONTROLLER_MAC[5]);
  esp_err_t err = esp_now_send(MAIN_CONTROLLER_MAC, (const uint8_t *)&pkt, sizeof(pkt));
  if (err != ESP_OK) {
    Serial.printf("[ESP-NOW] Nav command queue error: 0x%x\n", err);
  } else {
    Serial.println("[ESP-NOW] Nav command queued");
  }
}

void handleStop()      { Serial.println("Nav: STOP");      sendNavigationCommand(NAV_STOP);     }
void handleGoForward() { Serial.println("Nav: Forward");   sendNavigationCommand(NAV_FORWARD);  }
void handleTurnLeft()  { Serial.println("Nav: Left");      sendNavigationCommand(NAV_LEFT);     }
void handleTurnRight() { Serial.println("Nav: Right");     sendNavigationCommand(NAV_RIGHT);    }
void handleSpeedUp()   { Serial.println("Nav: Speed Up");  sendNavigationCommand(NAV_SPEEDUP);  }
void handleSlowDown()  { Serial.println("Nav: Slow Down"); sendNavigationCommand(NAV_SLOWDOWN); }
void handleBackUp()    { Serial.println("Nav: Back Up");   sendNavigationCommand(NAV_BACKWARD); }
void handleSpeak()     { Serial.println("Nav: Speak");     sendNavigationCommand(NAV_SPEAK);    }

// =========================================================
// WEBSOCKET STATUS HELPER
// =========================================================

// Forward declaration — defined just before onWsEvent below.
void sendStatus(AsyncWebSocketClient* client);

// =========================================================
// WEBSOCKET MESSAGE HANDLER
// =========================================================

void handleWebSocketMessage(const char* msg) {
  JsonDocument doc;
  if (deserializeJson(doc, msg) != DeserializationError::Ok) return;

  const char* type = doc["type"] | "";

  if (strcmp(type, "config") == 0) {
    if (!doc["zoneMode"].isNull()) {
      int mode = doc["zoneMode"].as<int>();
      if (mode == 4 || mode == 6 || mode == 8) currentZoneMode = mode;
    }
    if (!doc["brightness"].isNull()) {
      currentBrightness = brightnessRawFromPercent(doc["brightness"].as<float>());
    }
    if (!doc["redThreshold"].isNull() && !doc["orangeThreshold"].isNull() && !doc["yellowThreshold"].isNull()) {
      float redMm = doc["redThreshold"].as<float>() * 10.0f;
      float orangeMm = doc["orangeThreshold"].as<float>() * 10.0f;
      float yellowMm = doc["yellowThreshold"].as<float>() * 10.0f;
      if (redMm > 0 && orangeMm > redMm && yellowMm > orangeMm) {
        applyThresholds(redMm, orangeMm, yellowMm);
      }
    }
    if (!doc["activeSectors"].isNull()) {
      JsonArray sectors = doc["activeSectors"].as<JsonArray>();
      int count = min((int)sectors.size(), 8);
      for (int i = 0; i < count; i++) currentActiveSectors[i] = sectors[i].as<bool>();
    }
    if (!doc["audioEnabled"].isNull()) {
      audioEnabled = doc["audioEnabled"].as<bool>();
    }
    if (!doc["visualEnabled"].isNull()) {
      bool newVis = doc["visualEnabled"].as<bool>();
      if (visualEnabled && !newVis) { sendClearFrame(); }
      visualEnabled = newVis;
    }
    if (!doc["renderMode"].isNull()) {
      int mode = doc["renderMode"].as<int>();
      if (mode == LED_RENDER_MODE_SECTOR_FILL || mode == LED_RENDER_MODE_RADAR) {
        currentRenderMode = (uint8_t)mode;
      }
    }
    if (!doc["toneRedPitchHz"].isNull())    toneRedPitchHz    = (uint16_t)constrain(doc["toneRedPitchHz"].as<int>(),    200, 4000);
    if (!doc["toneRedTempoMs"].isNull())    toneRedTempoMs    = (uint16_t)constrain(doc["toneRedTempoMs"].as<int>(),    50,  2000);
    if (!doc["toneOrangePitchHz"].isNull()) toneOrangePitchHz = (uint16_t)constrain(doc["toneOrangePitchHz"].as<int>(), 200, 4000);
    if (!doc["toneOrangeTempoMs"].isNull()) toneOrangeTempoMs = (uint16_t)constrain(doc["toneOrangeTempoMs"].as<int>(), 50,  2000);
    if (!doc["toneYellowPitchHz"].isNull()) toneYellowPitchHz = (uint16_t)constrain(doc["toneYellowPitchHz"].as<int>(), 200, 4000);
    if (!doc["toneYellowTempoMs"].isNull()) toneYellowTempoMs = (uint16_t)constrain(doc["toneYellowTempoMs"].as<int>(), 50,  2000);
    if (!doc["audioMode"].isNull())        audioMode = (uint8_t)constrain(doc["audioMode"].as<int>(), 0, 1);
    if (!doc["obstacleVolume"].isNull())   obstacleVolume = (uint8_t)constrain(doc["obstacleVolume"].as<int>(), 0, 255);
    Serial.printf("[Config] zoneMode=%d  brightness=%d%%  audio=%s  visual=%s  audioMode=%d\n",
                  currentZoneMode, brightnessPercentFromRaw(currentBrightness),
                  audioEnabled ? "on" : "off", visualEnabled ? "on" : "off", (int)audioMode);

    // Relay updated settings to MainController so its zone computation matches.
    // While preview is active, keep MainController visual output disabled so it
    // cannot overwrite the preview frame being sent directly to LED controller.
    sendConfigToMainController(previewMode ? 0 : -1);

  } else if (strcmp(type, "navigate") == 0) {
    const char* action = doc["action"] | "";
    if      (strcmp(action, "forward")  == 0) handleGoForward();
    else if (strcmp(action, "backward") == 0) handleBackUp();
    else if (strcmp(action, "left")     == 0) handleTurnLeft();
    else if (strcmp(action, "right")    == 0) handleTurnRight();
    else if (strcmp(action, "stop")     == 0) handleStop();
    else if (strcmp(action, "speedup")  == 0) handleSpeedUp();
    else if (strcmp(action, "slowdown") == 0) handleSlowDown();
    else if (strcmp(action, "speak")    == 0) handleSpeak();
    else if (strcmp(action, "stayonline") == 0) handleSpeak();

  } else if (strcmp(type, "volume") == 0) {
    currentVolume = constrain(doc["level"].as<int>(), 0, 255);
    Serial.printf("[Volume] %d\n", currentVolume);
    sendConfigToMainController();

  } else if (strcmp(type, "preview") == 0) {
    bool active = doc["active"].as<bool>();
    if (!active) {
      previewMode = false;
      sendClearFrame();
      sendConfigToMainController();
      Serial.println("[Preview] Disabled — resuming obstacle detection");
    } else {
      previewMode = true;
      sendConfigToMainController(0);

      int mode = doc["zoneMode"] | previewZoneMode;
      if (mode == 4 || mode == 6 || mode == 8) previewZoneMode = mode;

      if (!doc["brightness"].isNull()) {
        previewBrightness = brightnessRawFromPercent(doc["brightness"].as<float>());
      }
      if (!doc["redThreshold"].isNull() && !doc["orangeThreshold"].isNull() && !doc["yellowThreshold"].isNull()) {
        float rMm = doc["redThreshold"].as<float>() * 10.0f;
        float oMm = doc["orangeThreshold"].as<float>() * 10.0f;
        float yMm = doc["yellowThreshold"].as<float>() * 10.0f;
        if (rMm > 0 && oMm > rMm && yMm > oMm) {
          previewRedMm = rMm;
          previewOrangeMm = oMm;
          previewYellowMm = yMm;
        }
      }
      if (!doc["activeSectors"].isNull()) {
        JsonArray sectors = doc["activeSectors"].as<JsonArray>();
        int count = min((int)sectors.size(), 8);
        for (int i = 0; i < count; i++) previewActiveSectors[i] = sectors[i].as<bool>();
      }

      lightPreview();
      Serial.printf("[Preview] zoneMode=%d  brightness=%d%%  red=%.0fmm  orange=%.0fmm  yellow=%.0fmm\n",
                    previewZoneMode, brightnessPercentFromRaw(previewBrightness),
                    previewRedMm, previewOrangeMm, previewYellowMm);
    }

  } else if (strcmp(type, "getConfig") == 0) {
    sendStatus(nullptr); // handled below — forward declaration keeps this clean
  }
}

// =========================================================
// WEBSOCKET STATUS HELPER (definition)
// =========================================================

void sendStatus(AsyncWebSocketClient* client) {
  uint32_t nowMs = millis();
  bool mainControllerConnected =
      (lastMainControllerStatusMs != 0) &&
      ((nowMs - lastMainControllerStatusMs) <= COMPONENT_TIMEOUT_MS);
  bool ledControllerConnected =
      (lastLedControllerStatusMs != 0) &&
      ((nowMs - lastLedControllerStatusMs) <= COMPONENT_TIMEOUT_MS);

  uint8_t sensorMask = mainControllerConnected ? latestSensorSeenMask : 0;
  // Left pod:   sensors 1-2 → bits 0-1
  // Right pod:  sensors 3-4 → bits 2-3
  // Tower pod:  sensors 5-8 → bits 4-7
  int leftPodOnlineSensors  = 0;
  int rightPodOnlineSensors = 0;
  int towerPodOnlineSensors = 0;
  for (int i = 0; i < 2; i++) if ((sensorMask >> i) & 0x01) leftPodOnlineSensors++;
  for (int i = 2; i < 4; i++) if ((sensorMask >> i) & 0x01) rightPodOnlineSensors++;
  for (int i = 4; i < 8; i++) if ((sensorMask >> i) & 0x01) towerPodOnlineSensors++;

  const char* leftPodState  = (leftPodOnlineSensors  == 2) ? "online"
                            : (leftPodOnlineSensors  == 0) ? "offline" : "degraded";
  const char* rightPodState = (rightPodOnlineSensors == 2) ? "online"
                            : (rightPodOnlineSensors == 0) ? "offline" : "degraded";
  const char* towerPodState = (towerPodOnlineSensors == 4) ? "online"
                            : (towerPodOnlineSensors == 0) ? "offline" : "degraded";

  JsonDocument doc;
  doc["type"]           = "status";
  doc["zoneMode"]       = currentZoneMode;
  doc["brightness"]     = brightnessPercentFromRaw(currentBrightness);
  doc["redThreshold"]   = (int)(DIST_RING2 / 10.0f);
  doc["orangeThreshold"]= (int)(DIST_RING3 / 10.0f);
  doc["yellowThreshold"]= (int)(DIST_RING4 / 10.0f);
  doc["audioEnabled"]   = audioEnabled;
  doc["visualEnabled"]  = visualEnabled;
  doc["renderMode"]     = (int)currentRenderMode;
  doc["mainControllerConnected"] = mainControllerConnected;
  doc["ledControllerConnected"] = ledControllerConnected;
  doc["leftPodState"] = leftPodState;
  doc["rightPodState"] = rightPodState;
  doc["towerPodState"] = towerPodState;
  doc["leftPodOnlineSensors"] = leftPodOnlineSensors;
  doc["rightPodOnlineSensors"] = rightPodOnlineSensors;
  doc["towerPodOnlineSensors"] = towerPodOnlineSensors;
  doc["sensorSeenMask"] = sensorMask;
  doc["mainControllerAgeMs"] =
      mainControllerConnected ? (int)(nowMs - lastMainControllerStatusMs) : -1;
  doc["ledControllerAgeMs"] =
      ledControllerConnected ? (int)(nowMs - lastLedControllerStatusMs) : -1;

  doc["toneRedPitchHz"]    = toneRedPitchHz;
  doc["toneRedTempoMs"]    = toneRedTempoMs;
  doc["toneOrangePitchHz"] = toneOrangePitchHz;
  doc["toneOrangeTempoMs"] = toneOrangeTempoMs;
  doc["toneYellowPitchHz"] = toneYellowPitchHz;
  doc["toneYellowTempoMs"] = toneYellowTempoMs;
  doc["audioMode"]         = (int)audioMode;
  doc["obstacleVolume"]    = (int)obstacleVolume;
  JsonArray arr = doc["activeSectors"].to<JsonArray>();
  for (int i = 0; i < currentZoneMode; i++) arr.add(currentActiveSectors[i]);
  JsonArray sensors = doc["sensorOnline"].to<JsonArray>();
  for (int i = 0; i < 8; i++) sensors.add(((sensorMask >> i) & 0x01) != 0);
  String out;
  serializeJson(doc, out);
  if (client) client->text(out);
  else        wsServer.textAll(out);
}

// =========================================================
// WEBSOCKET EVENT HANDLER
// =========================================================

void onWsEvent(AsyncWebSocket* /*server*/, AsyncWebSocketClient* client,
               AwsEventType type, void* arg, uint8_t* data, size_t len) {
  if (type == WS_EVT_CONNECT) {
    Serial.printf("[WS] Client #%u connected from %s\n",
                  client->id(), client->remoteIP().toString().c_str());
    sendStatus(client);

  } else if (type == WS_EVT_DISCONNECT) {
    Serial.printf("[WS] Client #%u disconnected\n", client->id());

  } else if (type == WS_EVT_DATA) {
    AwsFrameInfo* info = (AwsFrameInfo*)arg;
    if (info->final && info->index == 0 && info->len == len
        && info->opcode == WS_TEXT) {
      data[len] = 0; // null-terminate
      handleWebSocketMessage((char*)data);
    }
  }
}

// =========================================================
// SETUP & LOOP
// =========================================================

void setup() {
  Serial.begin(115200);

  // SPIFFS (serves the TypeScript UI)
  if (!SPIFFS.begin(true)) {
    Serial.println("[SPIFFS] Mount failed — UI will not be served");
  }

  // I2S audio
  setupI2S();

  // WiFi Access Point — channel 1 must match the LED ESP32's ESPNOW_CHANNEL
  WiFi.softAP(WIFI_SSID, WIFI_PASS, ESPNOW_CHANNEL);
  Serial.print("[WiFi] AP started — IP: ");
  Serial.println(WiFi.softAPIP());

  // ESP-NOW sender (LED ring driven by peer ESP32)
  initEspNow();

  // WebSocket
  wsServer.onEvent(onWsEvent);
  httpServer.addHandler(&wsServer);

  // Serve UI from SPIFFS; SPA uses hash routing so all paths → index.html.
  // index.html itself is served with no-cache so the browser always fetches the
  // latest file (which carries the correct hashed asset filenames).
  // Hashed assets (/assets/*.js, /assets/*.css) can be cached freely.
  httpServer.on("/", HTTP_GET, [](AsyncWebServerRequest* req) {
    AsyncWebServerResponse* res = req->beginResponse(SPIFFS, "/index.html", "text/html");
    res->addHeader("Cache-Control", "no-cache");
    req->send(res);
  });
  httpServer.serveStatic("/assets/", SPIFFS, "/assets/");
  httpServer.onNotFound([](AsyncWebServerRequest* req) {
    AsyncWebServerResponse* res = req->beginResponse(SPIFFS, "/index.html", "text/html");
    res->addHeader("Cache-Control", "no-cache");
    req->send(res);
  });

  httpServer.begin();
  Serial.println("[HTTP] Server started on port 80");

  // Sync default settings to MainController on boot
  sendConfigToMainController();
  Serial.println("[Config] Initial settings sent to MainController");
}

void loop() {
  // Keep WebSocket connections clean
  wsServer.cleanupClients();

  uint32_t nowMs = millis();
  if ((nowMs - lastWsStatusBroadcastMs) >= WS_STATUS_PERIOD_MS) {
    lastWsStatusBroadcastMs = nowMs;
    sendStatus(nullptr);
  }

}
