nicholas12136/Senior-Design-Vivisense/(commit log)

2025-11-23 Added my code
    Added my code and organized a bit
    [approach_wall_s1_s2_100rows.csv, diag_single_column_close_res16.csv, scene_01_approach_wall_turn_right_res16_correct.csv, scene_01_approach_wall_turn_right_res64_correct (1).csv, scene_01_approach_wall_turn_right_res64_correct.csv, scene_02_navigate_between_humans_res16_correct.csv, scene_02_navigate_between_humans_res64_correct.csv, scene_03_pass_human_on_right_res16_correct.csv]
2025-11-24 Updated Sensor Code
2025-11-24 Modified sensor code
2025-12-01 More Sensor Testing
    [LongHallwayLeft.csv, LongHallwayLeftFormatted.csv, approach_wall_s1_s2_100rows.csv, diag_single_column_close_res16.csv, scene_01_approach_wall_turn_right_res16_correct.csv, scene_01_approach_wall_turn_right_res64_correct (1).csv, scene_01_approach_wall_turn_right_res64_correct.csv, scene_02_navigate_between_humans_res16_correct.csv]
2025-12-01 Changes for ppt
    [LeftHallway300frames.csv]
2026-02-03 Updated sensor firmware
2026-02-04 Updated LED code
    [SimOutput_XYZ_Values.csv, unityTest_8Sensors_final.csv]
2026-02-10 Sensor Changes
2026-02-10 Sensor Updates
2026-02-26 Added WevserverV2 and IMU code
2026-02-26 Working PC and Occ Grid
    [vivisense_calib_points_20260222_194241.csv, vivisense_occupancy_points_20260224_132355.csv, vivisense_occupancy_points_20260224_132618.csv, vivisense_points_20260222_170837.csv, vivisense_points_20260222_174225.csv, vivisense_serial_points_20260223_195218.csv, vivisense_serial_points_20260223_200926.csv, vivisense_serial_points_20260223_203020.csv]
2026-03-17 Updated from pres
    [vivisense_calib_points_20260222_194241.csv, vivisense_occupancy_points_20260224_132355.csv, vivisense_occupancy_points_20260224_132618.csv, vivisense_occupancy_points_20260302_133422.csv, vivisense_occupancy_points_20260302_133522.csv, vivisense_occupancy_points_20260302_134238.csv, vivisense_occupancy_points_20260302_134918.csv, vivisense_occupancy_points_20260302_135249.csv]
2026-04-14 Updated Webserver
    [Diffraction Cover.step, LED Holder.step, Outer Cover.step, Updated Clamp.stl]
2026-04-17 small changes
    [LEDHolderV2.stl]
2026-04-20 updated webserver & added LED
2026-04-21 Add beta self-contained feedback path
    - Fix VL53L7CX target status validation: points are now only marked
    valid when targetStatus == 5 (100% confidence), eliminating phantom
    obstacle alerts from noise and wrap-around readings
    - Add ZoneProximityPacket broadcast from MainController: proximity
    detection runs at 15 Hz, accumulating closest obstacle per zone
    across all 8 sensors and broadcasting to CaregiverApp via ESP-NOW
    - Add ConfigPacket relay from CaregiverApp: zone mode, brightness,
    distance thresholds, and active sectors are relayed from the
    browser UI to MainController on every config change and on boot
    - Remove alpha obstacle path from CaregiverApp: the browser->obstacle
    W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
    [SensorAndPoint.h, led_frame.h, main.cpp]
2026-04-21 Add system documentation
    Covers hardware layout, data flow (alpha and beta paths),
    coordinate system, sensor geometry, target status filtering,
    zone modes, LED feedback logic, all ESP-NOW packet types,
    WebSocket protocol, firmware targets, and known limitations.
2026-04-21 Refactor live LED path to LED controller and rename firmware projects
2026-04-21 baseline update
    [SimOutput_XYZ_Values.csv, unityTest_8Sensors_final.csv]
2026-04-21 Fixed sector to light up all of sector mode
    [main.cpp]
2026-04-22 Fixed LED
2026-04-22 changed led feedback
2026-04-24 fixed audio and led stuff
    [LEDRingController_ArduinoIDE.ino, main.cpp]
2026-04-30 tuned grid and tried to fix sliders
    [main.cpp, runtime_defaults.h, serial_presentation_polar_grid_viewer.py]
2026-05-02 update mechanical prints
    [Diffraction Cover.step, LED Holder.step, LEDHolderV2.stl, Outer Cover.step, TowerConnector_to_tower.step, TowerLconnector.step, TowerLconnector_mirrored.stl, Updated Clamp.stl]
